praveengnan94/Qwerty-Pen/Pictures/LIST OF PICTURES DRAWN.jpeg

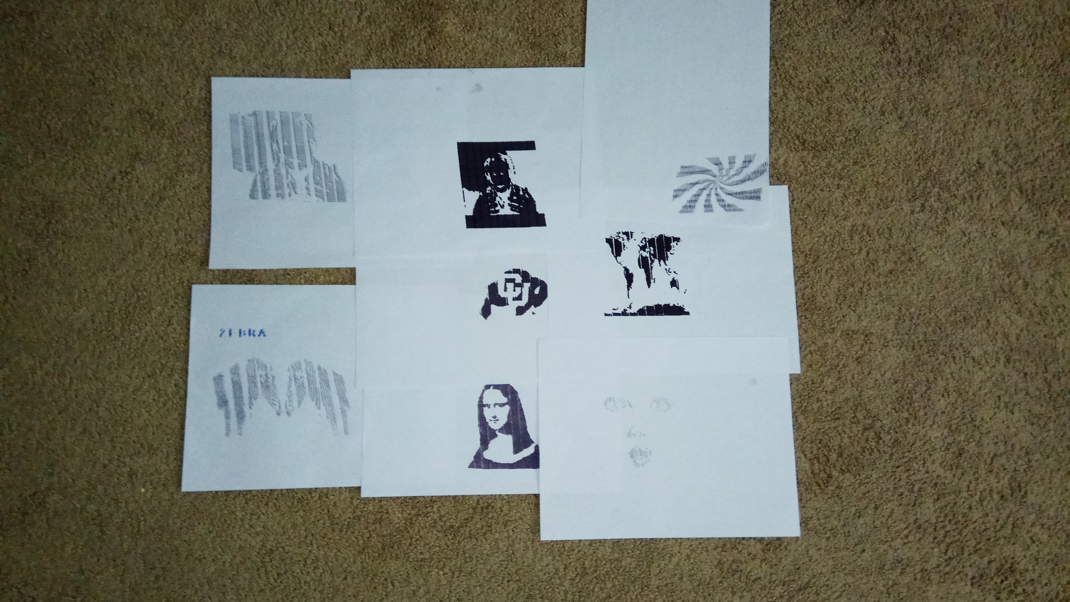
Pictures/LIST OF PICTURES DRAWN.jpeg
