praveengnan94/Qwerty-Pen/README.md

# Qwerty-Pen
Project for Embedded System Design course (ECEN 5613)
