praveengnan94/Qwerty-Pen/Report/APPENDIX.docx

## Appendix - Data Sheets and Application Notes

1) “Servo Motor datasheet” (http://cdn.sparkfun.com/datasheets/Robotics/Small%20Servo%20-%20ROB-09065.pdf)http://cdn.sparkfun.com/datasheets/Robotics/Small%20Servo%20-%20ROB-09065.pdf

2) “NEMA 17 stepper motor”

https://cdn-shop.adafruit.com/product-files/324/C140-A+datasheet.jpg

3) “Stepper motor driver datasheet” (https://www.pololu.com/file/0J450/A4988.pdf)https://www.pololu.com/file/0J450/A4988.pdf

4) “RF 2.4GHz Bluetooth datasheet” http://robokits.download/downloads/RF2_4GHzSerialLink.pdf
