praveengnan94/Qwerty-Pen/Presentations/F16_Gnanasekaran_SunilKumar_Plotter  final project demo.pptx

## QWERTY Pen Personal Writing/Drawing Device

QWERTY Pen - Praveen Gnanasekaran & Vijoy Sunil Kumar

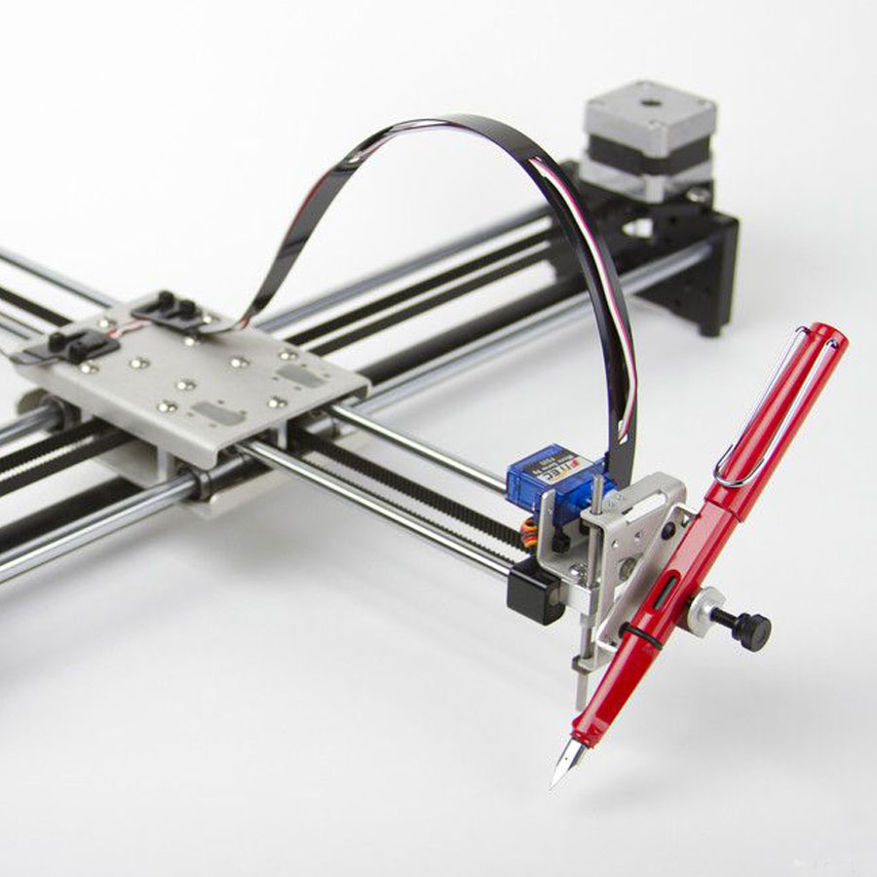
[picture p15: figure]

Source: AxiDraw

Praveen Gnanasekaran & Vijoy Sunil Kumar

## Hardware Implementation

STEPPER MOTORS 1 & 2

1

X

UART

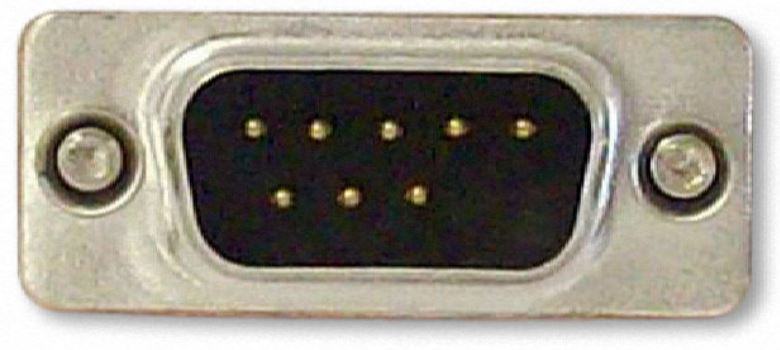
[picture p16: figure]

STEPPER
MOTOR
DRIVER

PC

8051

16x4
LCD

2

abc

SERVO MOTOR

Python bitmap script

LCD CONTROL BUTTON

Y

## Problems faced

- Base and pen holder
Base not perfectly level (tried fixing with spirit levels)- resulting in the pen leaving impressions of different shades
Printing time made intentionally slower to get more uniform shades.
- Bluetooth interface
Transmission through Bluetooth not fast and lead to loss of packets during two way transmissions- fixed by replacing Bluetooth with wired UART
- Initial mechanical problems
