praveengnan94/Qwerty-Pen/Datasheets/3D print files/DrawingMachine_-_EndY2.stl

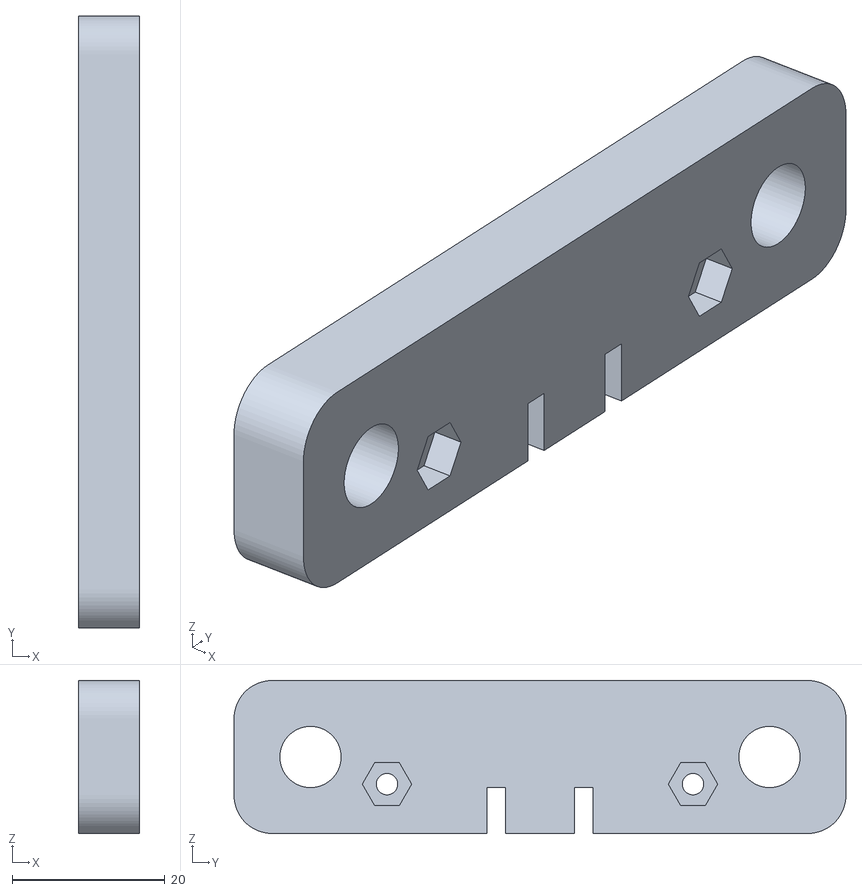
[picture p56: CAD file, 2017-02-17]
Datasheets/3D print files/DrawingMachine_-_EndY2.stl
8.00 x 80.0 x 20.0
