praveengnan94/Qwerty-Pen/Datasheets/3D print files/DrawingMachine_-_Arduino_grip.stl

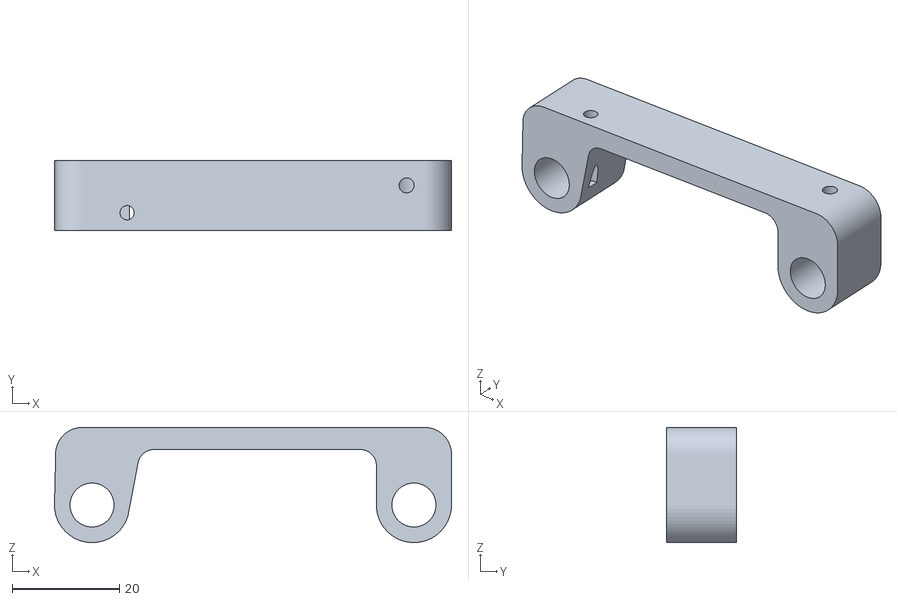
[picture p57: CAD file, 2017-02-17]
Datasheets/3D print files/DrawingMachine_-_Arduino_grip.stl
74.0 x 13.0 x 21.5
