praveengnan94/Qwerty-Pen/Datasheets/3D print files/DrawingMachine_-_newEndX.stl

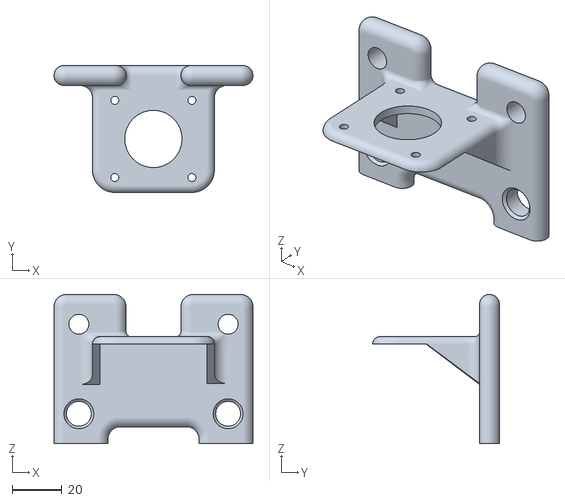
[picture p58: CAD file, 2017-02-17]
Datasheets/3D print files/DrawingMachine_-_newEndX.stl
80.0 x 51.0 x 60.0
