praveengnan94/Qwerty-Pen/Datasheets/3D print files/DrawingMachine_-_base_with_nuts.stl

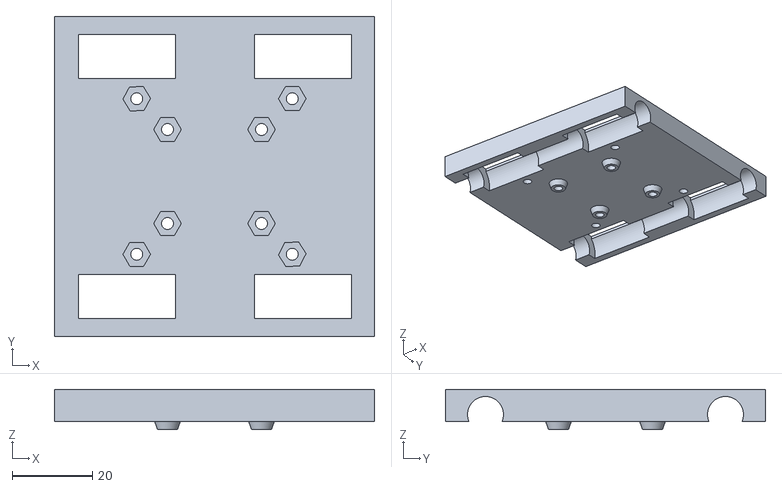
[picture p59: CAD file, 2017-02-17]
Datasheets/3D print files/DrawingMachine_-_base_with_nuts.stl
80.0 x 80.0 x 10.0
