praveengnan94/Qwerty-Pen/Datasheets/3D print files/DrawingMachine_-_Pen_holder_1.stl

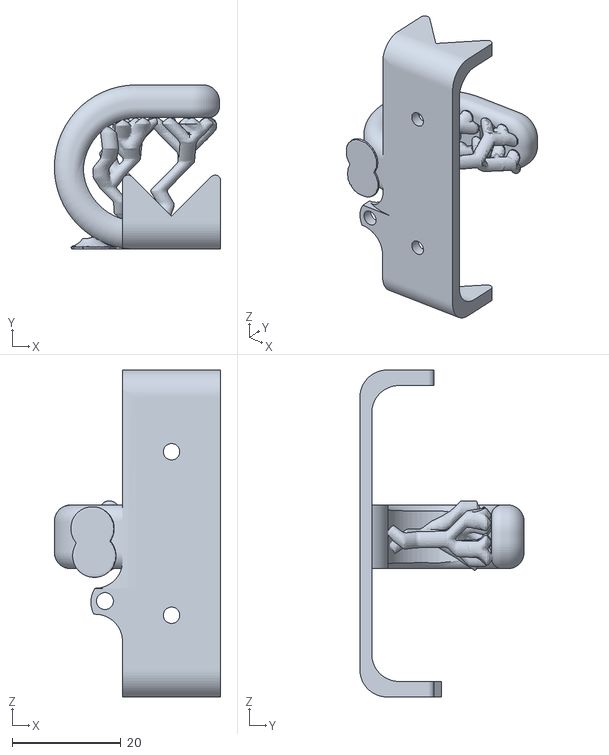
[picture p60: CAD file, 2017-02-17]
Datasheets/3D print files/DrawingMachine_-_Pen_holder_1.stl
30.5 x 30.1 x 60.0
