praveengnan94/Qwerty-Pen/(list of files, cad)

Other CAD files:
Datasheets/3D print files/DrawingMachine_-_base.stl
Datasheets/3D print files/DrawingMachine_-_EndY_2.stl
