praveengnan94/Qwerty-Pen/Schematics/QWERTY PEN Schematics.pdf

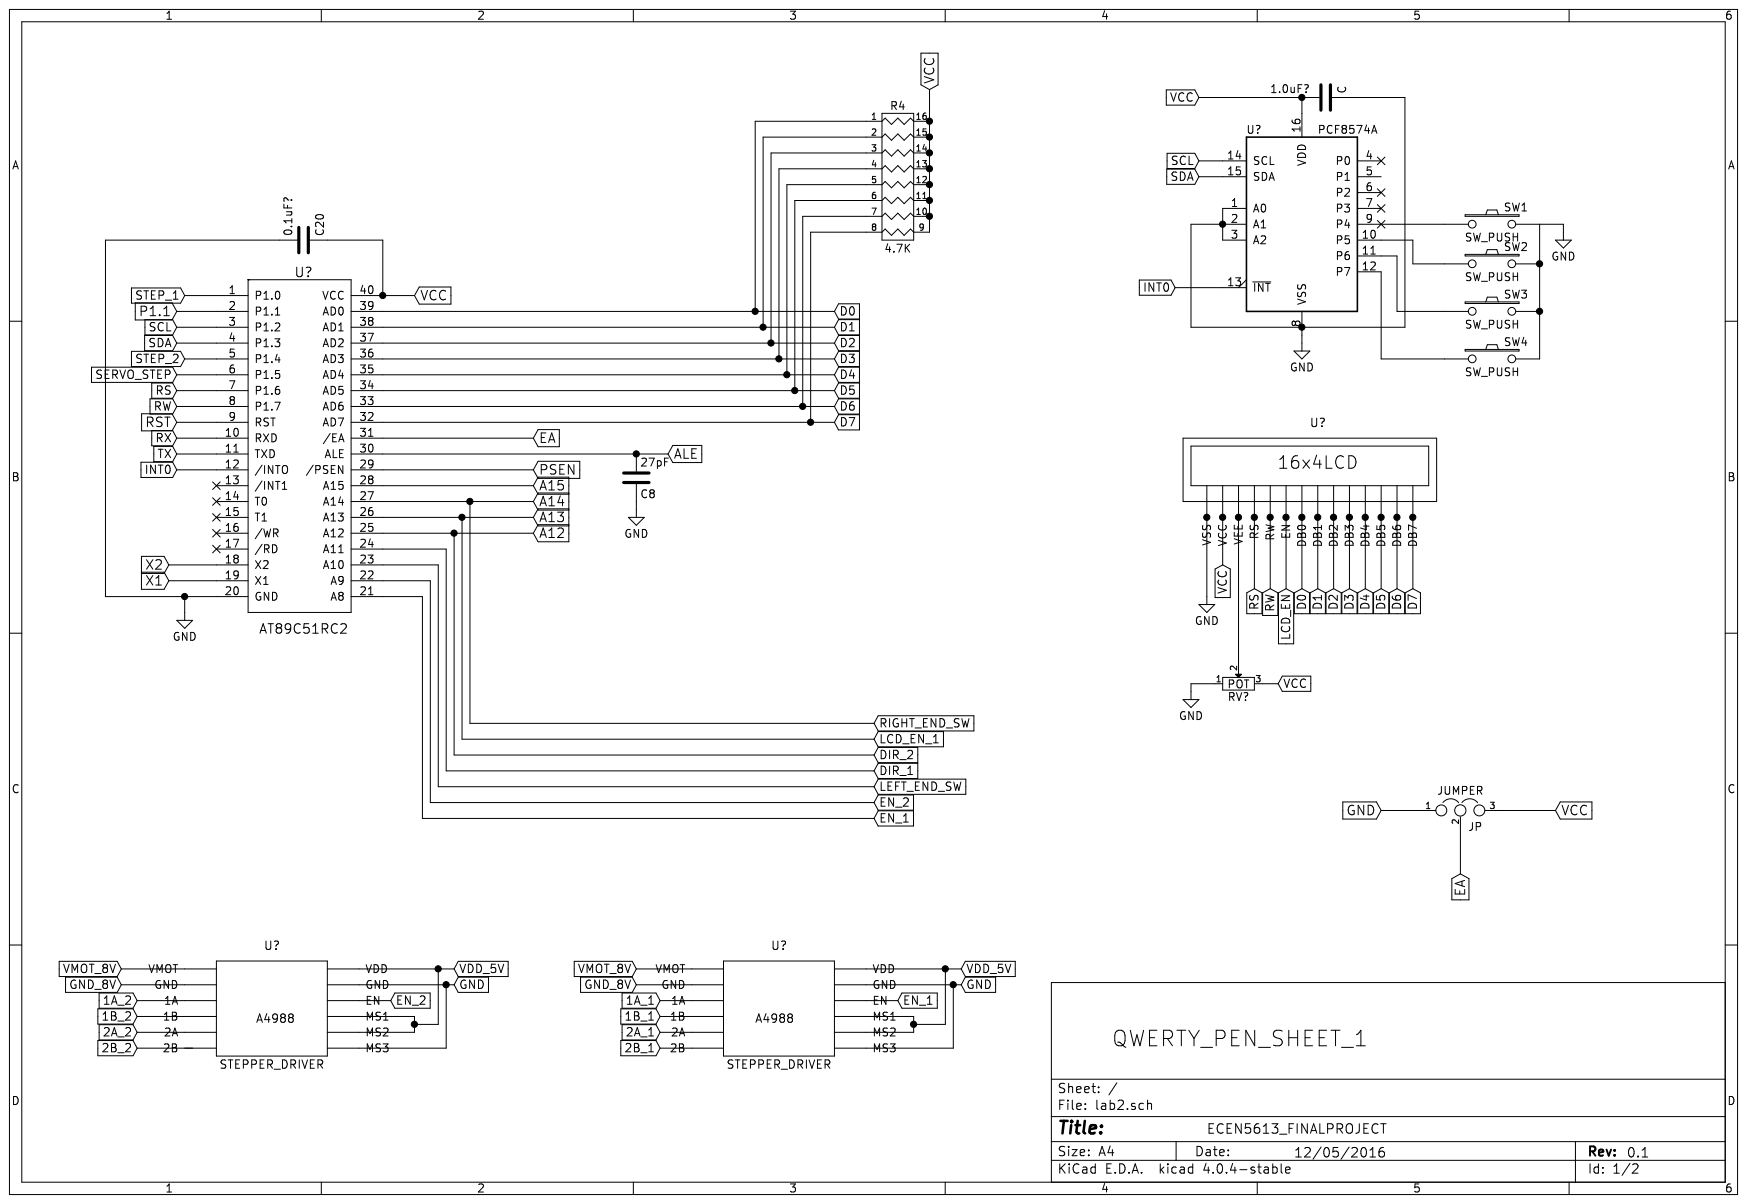
[picture p61: page 1]

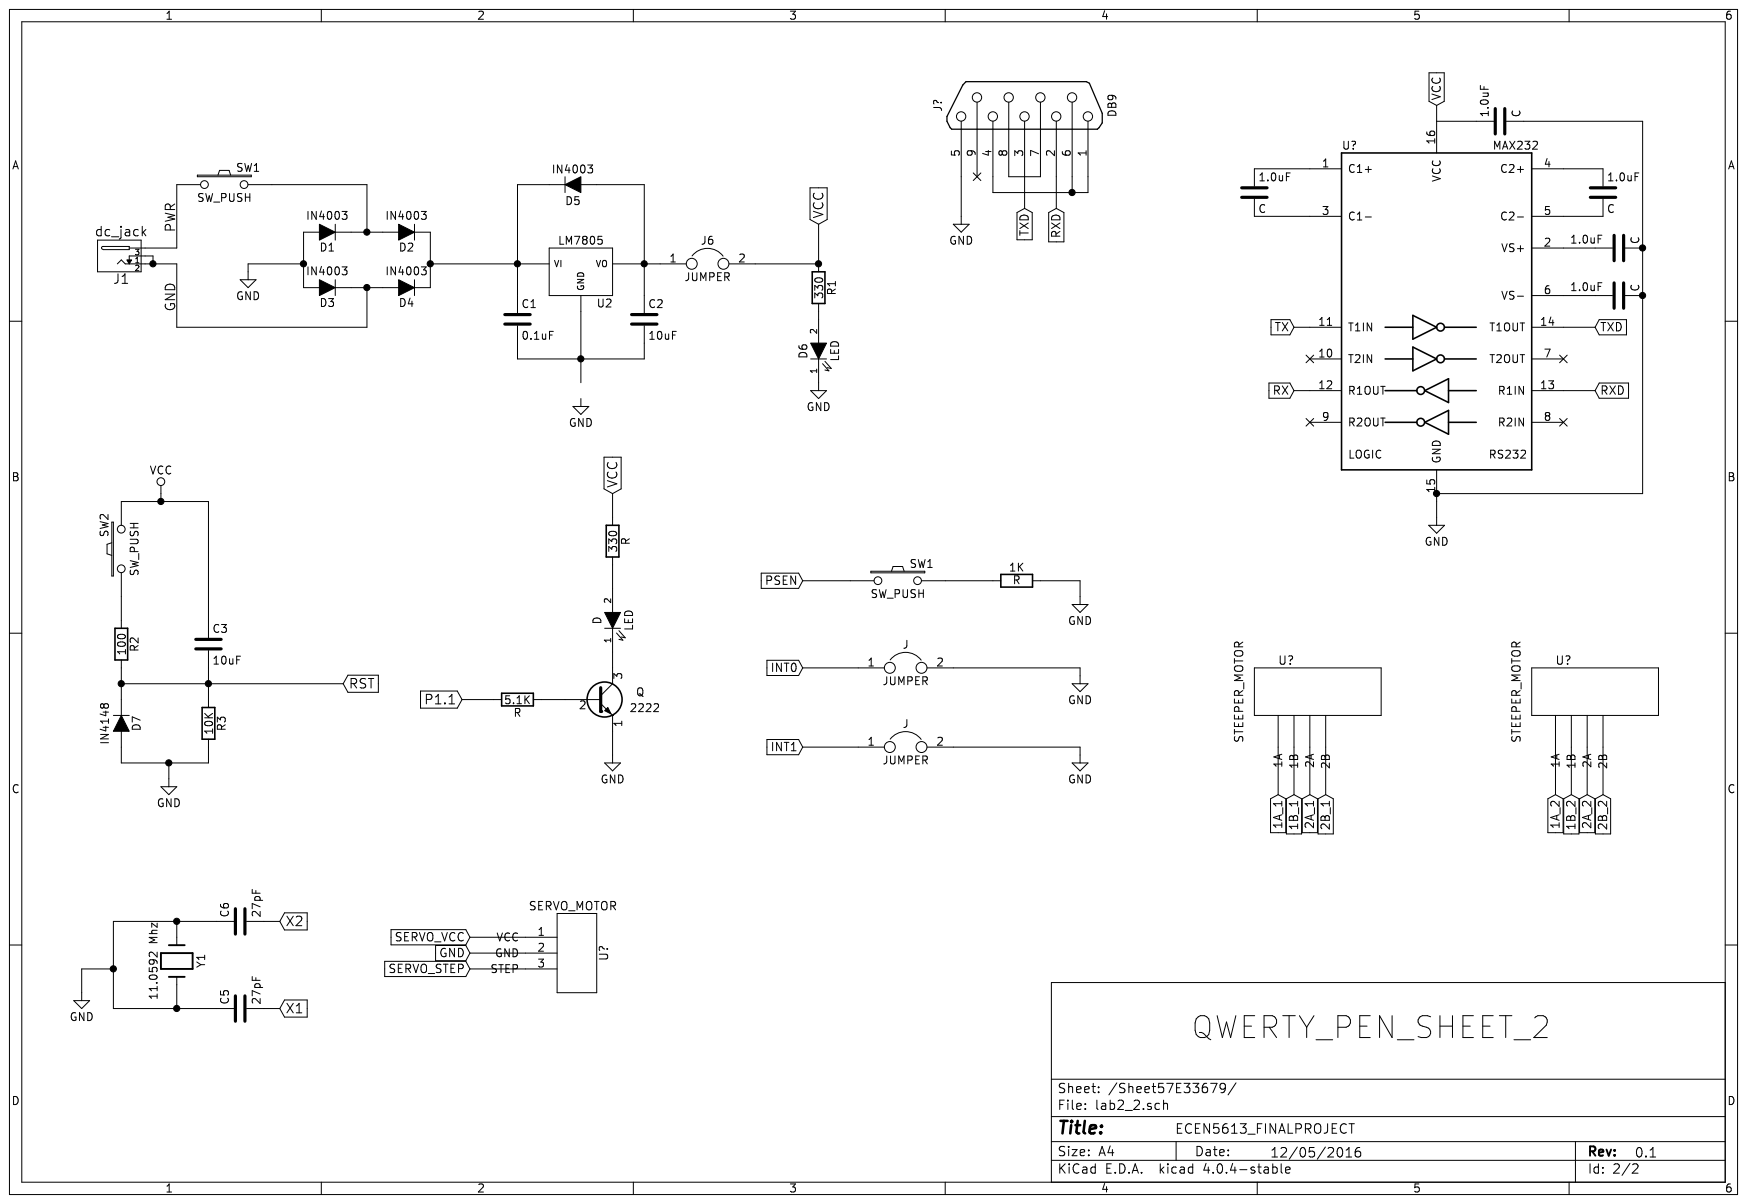
[picture p62: page 2]
