praveengnan94/Qwerty-Pen/Labs/Praveen/Lab3/max_baud_rate.asm

.org 0000h
MOV A,8EH
ORL A,#0CH
ANL A,#0ADH
MOV 8EH,A

MOV 087H,#080H;PCON	-Serial port Mode Bit 1 SET TO ENABLE DOUBLE BAUD RATE IN MODE 1,2 OR 3

ORL 098H,#050H;SCON  - Serial port Mode bit 1 SET TO 9 BIT UART (FXTAL/64 or FXTAL/32) AND Reception Enable bit SET


ORL 09BH,#002H;BDRCON- Baud Rate Speed Control bit for UART SET TO ENABLE FAST BAUD RATE GENERATOR


MOV 0CBH,#0FFH;RCAP2H - VALUES OF R2CAPH AND R2CAPL SET BY CALCULATING, REFER WRITEUP DOCUMENT 
MOV 0CAH,#0FDH;RCAP2L


ORL 0C8H,#034H;T2CON - RECEIVE AND TRANSMIT CLOCK BITS ENABLED, timer 2 Run Control Bit SET TO TURN TIMER2 ON

again: 
	MOV SBUF,#55H	
here: 
	JNB TI, here	;wait for the last bit
CLR TI				;clear TI for the next char
SJMP again			;keep sending A
