praveengnan94/Qwerty-Pen/Labs/Praveen/Lab4/conversions.h

//THIS HEADER FILE CONTAINS ALL CHARACTER TYPE CONVERSIONS THAT ARE DONE IN THE CODE

#ifndef CONVERSIONS_H_INCLUDED
#define CONVERSIONS_H_INCLUDED
#include "variables.h"


int power(int base, int exp);
void getstr(char* a,unsigned int in);
int power(int base, int exp);
void ascii_to_hex(char* b,unsigned int inr);


#endif // CONVERSIONS_H_INCLUDED
