praveengnan94/Qwerty-Pen/(commit log)

2017-02-17 ESD code, schematics, video and report
    Refer individual folders for more info
2017-02-17 Board schematics and layout
2017-02-17 Datasheet for motors, processors, and 3D design
    3D print files and datasheets
    [DrawingMachine_-_Arduino_grip.stl, DrawingMachine_-_EndY2.stl, DrawingMachine_-_EndY_2.stl, DrawingMachine_-_Pen_holder_1.stl, DrawingMachine_-_base.stl, DrawingMachine_-_base_with_nuts.stl, DrawingMachine_-_newEndX.stl]
